agandini/Fogduino/README.md

# Fogduino

Fogduino è un progetto che vuole prototipare un generatore di fumo capace di interagire tramite MQTT. Applicando corrente sulla resistenza, essa si riscalda facendo evaporare il liquido contenuto nel cotone sulla quale è avvolta, generando fumo (Seguendo il principio di funzionamento di una sigaretta elettronica).
Una ventola investe con il suo flusso d'aria la resistenza, controllando la temperatura e evaporazione del liquido,convogliando il fumo generato verso un uscita dove una fotoresistenza legge la riduzione di luce rispetto allo standard ambientale.
Pubblicazione tramite mqtt di dati relativi alla riduzione di "visibilità" della fotoresistenza quando il fumo viene erogato, temperatura rilevata e parametri di funzionamento, oltre alla ricezione di comandi da remoto.

## Hardware

- ESP8266 (ESP32) NodeMCU
- PC Fan (7x7cm, 12v,0,4A; 4 pin: +,-,pwm,rpm)
- Resistenza in lega da 1.3 Ohm, in lega Ni80, avvolta su cotone imbevuto di liquido
- 1x Relè 5VDC JQC-3FF-S-Z 
- Sensore temperatura ds18b20
- Fotoresistore
- Sensore IR di fiamma KY-026
- Vecchio alimentatore da PC 

## Schema
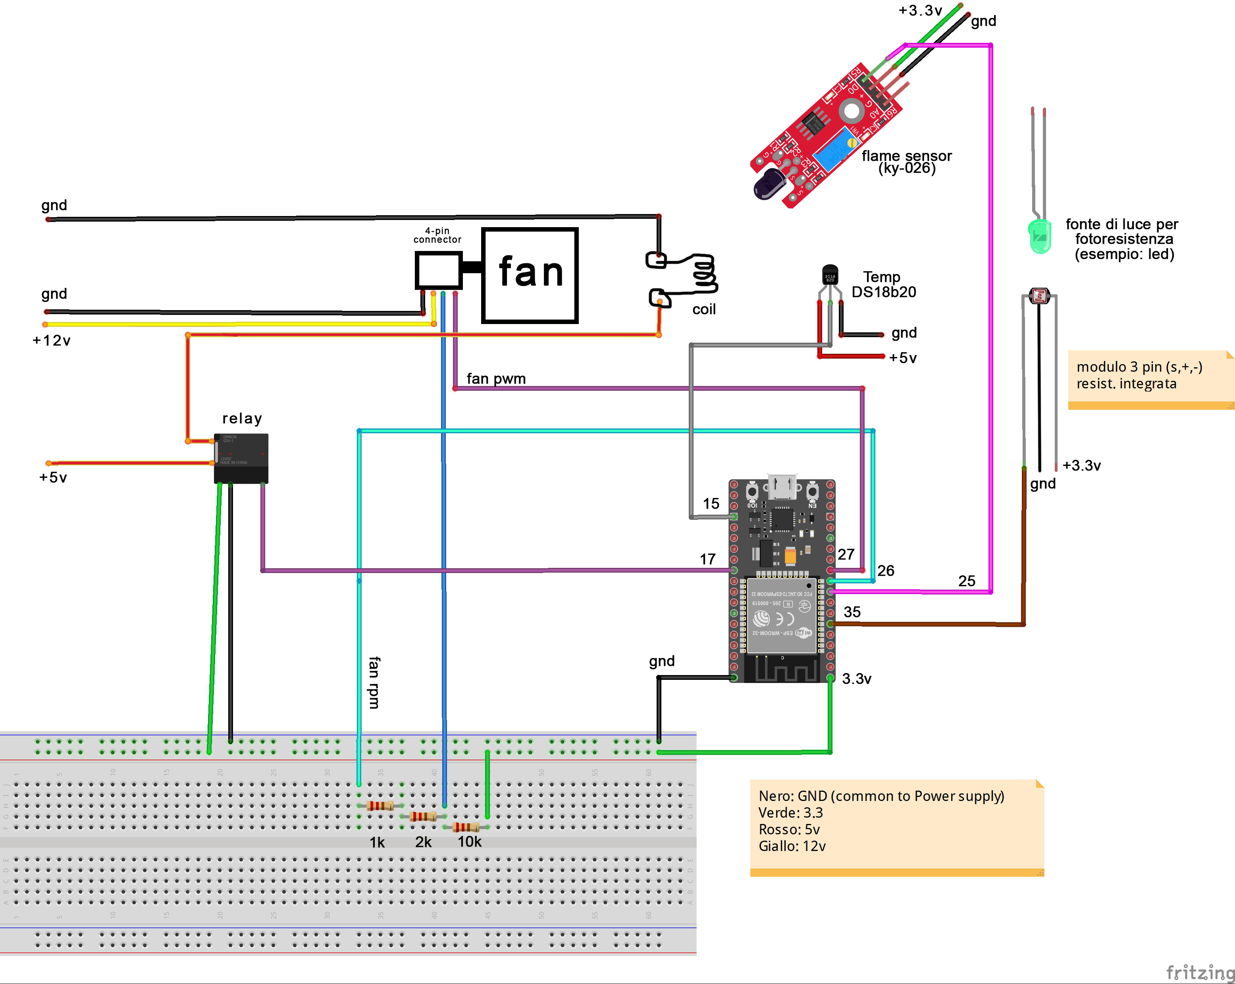
[picture p1: img/fogduino_bb.jpg]
Disegno dello schema progetto


Note: la Coil è da circa 1.3 Ohm, applicando 5v otteniamo circa 4 A, quindi siamo sui 20W di potenza.\
Non sono riuscito a reperire informazioni online riguardo a "cosa esca" fisicamente dall'uscita per contare gli rpm dalla ventola, ne a misurarla con un multimetro. Facendo un po' di prove, e seguendo questo [schema](https://esp32.com/viewtopic.php?f=19&t=13679&sid=1309e637ad6137b20bef39852a5a2172&start=20) senza utilizzare un condensatore (non a mia disposizione), i valori letti sembrano coerenti con reali valori di rpm plausibili per la ventola.

## Foto
Visione d'insieme del prototipo realizzato:

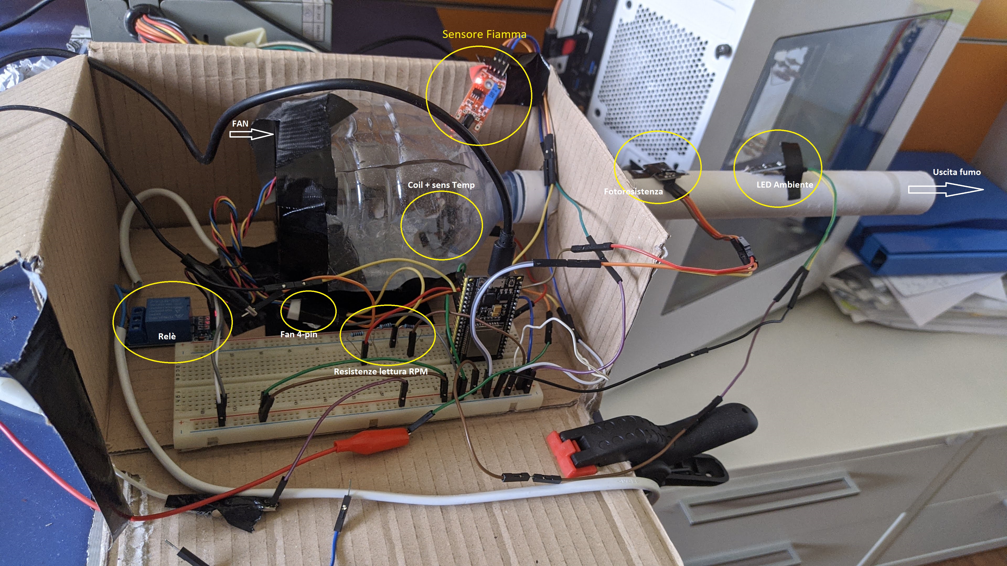
[picture p2: img/Prototipo.jpg]
 <br/><br/>

Primo piano sulla coil e sensore temperatura (girato al contrario!)<br/>

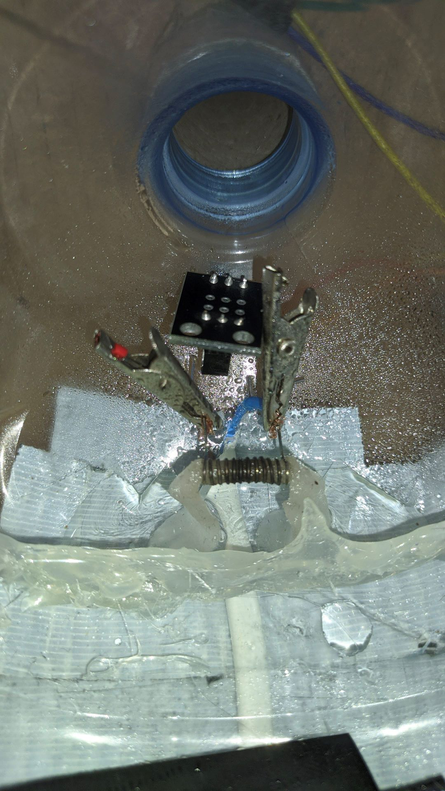
[picture p3: img/coil.jpg]
coil


  - Si possono notare i baffi in cotone della resistenza che vanno ad immergesi nel liquido da evaporare, che per effetto di capillarità tende a risalire fino al centro della coil. Con della colla a caldo ho realizzato una spece di vaschetta per contenerne un po'. Uso due morsetti per mantenere il contatto elettrrico tra la coil e i cavi.

## Links:
  - Board usata [ESP32](https://www.amazon.it/AZDelivery-sviluppo-successivo-versione-compatibile/dp/B08BTQ57ZV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) (Il venditore ora propone una versione "graficamente" diversa, ma dovrebbe essere la stessa)
  - MQTT - http://mqtt.org/
  - PubSubClient (MQTT) - https://pubsubclient.knolleary.net/
  - WiFi -https://www.arduino.cc/en/Reference/WiFi
  - [OneWire](https://www.arduino.cc/reference/en/libraries/onewire/) & [DallasTemperature](https://www.arduinolibraries.info/libraries/dallas-temperature)
