agandini/Fogduino/problems_encountered_and_workaround.md

# problemi, difficoltà e soluzioni alternative riscontrate durante sviluppo

## Lato Hardware
- Inizialmente, avrei voluto poter calcolare quanto la coil sia stata calda misurando la sua variazione di resistenza rispetto alla temperatura ambiente dalla quale si parte (coefficiente di temperatura).
Purtoppo dato che la variazione è davvero minima ( millesimi di ohm) e l'idea che prevedeva di usare l'esp32 come un [ohmmetro](https://create.arduino.cc/projecthub/iasonas-christoulakis/how-to-make-an-arduino-ohm-meter-90fda8) non è in grado di leggere sia varazioni così piccole che leggere proprio resistenze dal valore così basso (ho testato con una resistenza da circa 1 ohm ottendo scarsi risultati, e il surriscaldamento della stessa), è molto difficile poter calcolare la temperatura approssimativa in questo modo.
  - inoltre la resistenza dovrebbe venire attraversata da una corrente a circa 10A e 12v, anche la circuiteria si andrebbe a complicare per poter escludere l'alimentazione per il tempo necessario alla lettura della variazione.\
  ##UPDATE ->  Utilizzando l'uscita dal power supply a 5v anzichè a 12, ottengo migliropi risultati. Applicando 12v oltre che a rischiare spesso il surriscaldamento eccessivo della resistenza, anche applicando il "finto" pwm tramite il ralay si ottenevano picchi di fumo nel momento di carico, facendo fuoriuscire dal tubo erogatore il fumo a "sbuffi". Con 5v, quindi circa 20W ci vuole un pò piu di tempo per generare un buon quantitativo di fumo, ma è più gestibile e omogeneo, sempre mantenendo la stessa resistenza. Avrei potuto usare una resistenza maggiore sempre sul 12v, ma avrebbe ingrandito le dimensioni fisiche della resistenza (il numero di spire) e avrei dovuto riprogettare per così dire il prototipo e glia lloggiamenti della stessa.
  - --> come workaround solution intendo usare un sensore di temperatura ds18b20 posto dopo la resistenza, calcolando quindi la temperatura dell'aria che lo investe.

- Ventola: uso una vecchia ventola per processori desktop, con 4 pin (+, - , pwm, rpm) che controllo con il pin pwm e leggo come "feedback" dal pin rpm le pulsazioni di quando un giro della ventola viene effettuato(non sono sicuro sia 1 giro, alcuni modelli di ventole mandano 2 impulsi ogni rotazione).
[Ho preso spunto da qui](https://www.youtube.com/watch?v=UJK2JF8wOu8), nel video viene presentato su un arduino (a 5v dunque)e da una mia prova sembra funzionare perfettamente, ho provato a adattarlo per leggere da un esp32 (a 3.3v):in particolare ho messo in serie 2 resitenze ( una da 10k e una da 3k) in pullup su 3.3v e leggendo il segnale sul piede della resistenza da 3k (sembrano valori sensati quelli letti)

- Alimentazione liquido: la coil andrà inevitabilmente a esaurire il liquido da evaporare nel tempo, quindi per bagnarla avevo inizialmente pensato e costruito una piccola pompa a partire da un motorino a 5v.
Purtoppo mi è difficile gestirlo e manderebbe troppo liquido sulla resistenza, quindi l'idea per bagnare la coil è quella di "legarla" a un servomotore, che ogni tot tempo ruota di 90 gradi la resistenza "pucciandola" in una vaschettina contenete liquido sotto di essa.<br/>
  - Update: dopo un qualche prova, anche usare un servo per bagnare ogni tot la resistenza non è il massimo, anche perchè complica la reale costruzione dei cavi in quanto serve un pò di gioco per poterla muovere senza avere problemi. Inoltre, immergerla farebbe perdere molto calore accumulato riducendo nel tempo i vantaggi del "pwm" ottenuto con il relay.
Ho deciso infine per questo progetto di non gestire l'alimentazione, ovvero manualmente bagnare la coil prima di ogni utilizzo (comunque una volta impregnata, dura diverse decine di secondi), e lasciando dove cadono i "baffi" si cotone una piccola vaschetta contenente liquido, che viene assorbito col tempo. Utilizzare un serbatoio e una piccola pompa, o un sistema che faccia gocciolare sulla resistenza periodicamente un pò di liquido sarebbe un idea comunque valida da implementare per portare avanti il progetto.<br/>
--> non gestendo l'alimentazione del liquido della resistenza, inesorabilmente andrà a esaurire il liquido, seccandonsi. Non avendo implementato un modo per evitare il bruciarsi del cotone, che porterà al funesto evento di un piccolo incendio, si lascia all'utilizzatore la responsablità di non lasciare per troppo tempo il fogduino in funzione.<br/>
--> Ho aggiunto, come minima protezione molto speranzosa, un sensore IR di fiamma, che una volta raggiunto il punto in cui la resistenza emmtta una fiamma allora tento di spegnerla tagliando la corrente alla stessa e dando massima potenza alla ventola. Se ci fosse stato un sistema per bagnare la resistenza come ideato in partenza, allora anche esso avrebbe "affogato" la resistenza con il liquido per spegnere la fiamma. 

-Problema relay: inizialmente non riuscivo a gestire bene il relè associato alla resistenza (che uso in quanto scorrono circa 10 A di corrente verso essa ##UPDATE ora a 5v, scorrono circa 4A), in quanto da esp32 l'uscita digitale arriva a 3.3v, mentre generalmente questi relay funzionano a 5v con un trigger oltre i 4v. Fortunatamente, dal datasheet del mio modello [JQC-3FF-S-Z](https://en.tonglingrelay.com/product/1063.html), è possibile usarli con 3.3v il che mi ha risparmiato di dover comprare altri relè adeguati, o alla peggio usare un vecchio clone di arduino come "step-up" del segnale in uscita dall'esp32.

## Lato Software
- dual core: ho pensato di sfruttare i due core dell'esp32 per poter far girare sul secondo core la routine che mantiene il fumo in erogazione, ovvero setta la ventola a una certa velocita, mantiene la corrente sulla resistenza e ogni tot secondi la bagna. Ho un problema nella gestione del watchdog, mi obbliga a inserire un dealy per evitare di fermare la board.
In questo modo l'altro core eseguira tutto il resto: comunicazione mqtt, lettura sensori. //in testing 
- altra opzione sarebbe usare la libreria task scheduler, ma non l'ho provata (sarà possibile usarlo su 2 core?)
