agandini/Fogduino/(commit log)

2021-04-13 Add files via upload
    Testing fatto male di mqtt con uno switch per rispondere a comandi ricevuti.
2021-04-20 Add files via upload
    working wiki +mqtt. Added test stats for fan pwm/rpm, coil temp
2021-04-23 Added procedures to read sensors + little refactoring
